Saw-Fish/ESP32-C6-MicroDev/Examples/Arduino/README.md

## Arduino Examples

* ESP32-C6-DEV-ID.ino this is the barebones Arduino code loaded onto the device when purchased.
