Saw-Fish/ESP32-C6-MicroDev/Micro-Dev-V0.1/V0.1 README.md

# ESP32-C6-MicroDev 

## V0.1 

Pins on bottom of board are broken out via unpopulated JST SH headers.

The step file includes these headers for reference.

## Pinouts:



## Known Issues:

The labels on the RESET & BOOT buttons are switched, this will be fixed in the next version. The BOOT button will reset the device and the RESET button will put it into download mode.

The board edge may be slightly larger than the step file, this is due to the mousebites from the manufacturing process, these can be safely smoothed over with a fine file.
