Saw-Fish/ESP32-C6-MicroDev/Micro-Dev-V0.1/C6-Dev-0.1 Pinout.png

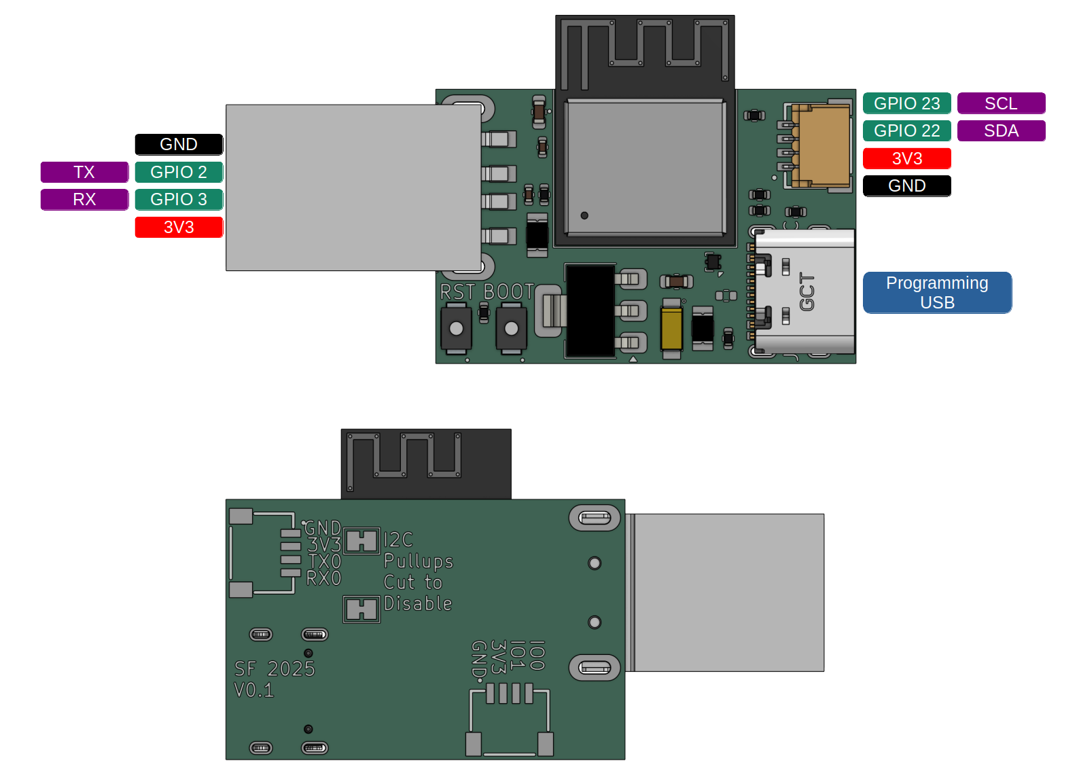
Micro-Dev-V0.1/C6-Dev-0.1 Pinout.png
