Saw-Fish/ESP32-C6-MicroDev/Micro-Dev-V0.1/ESP32-C6-MicroDev-V0.1 Schematic.pdf

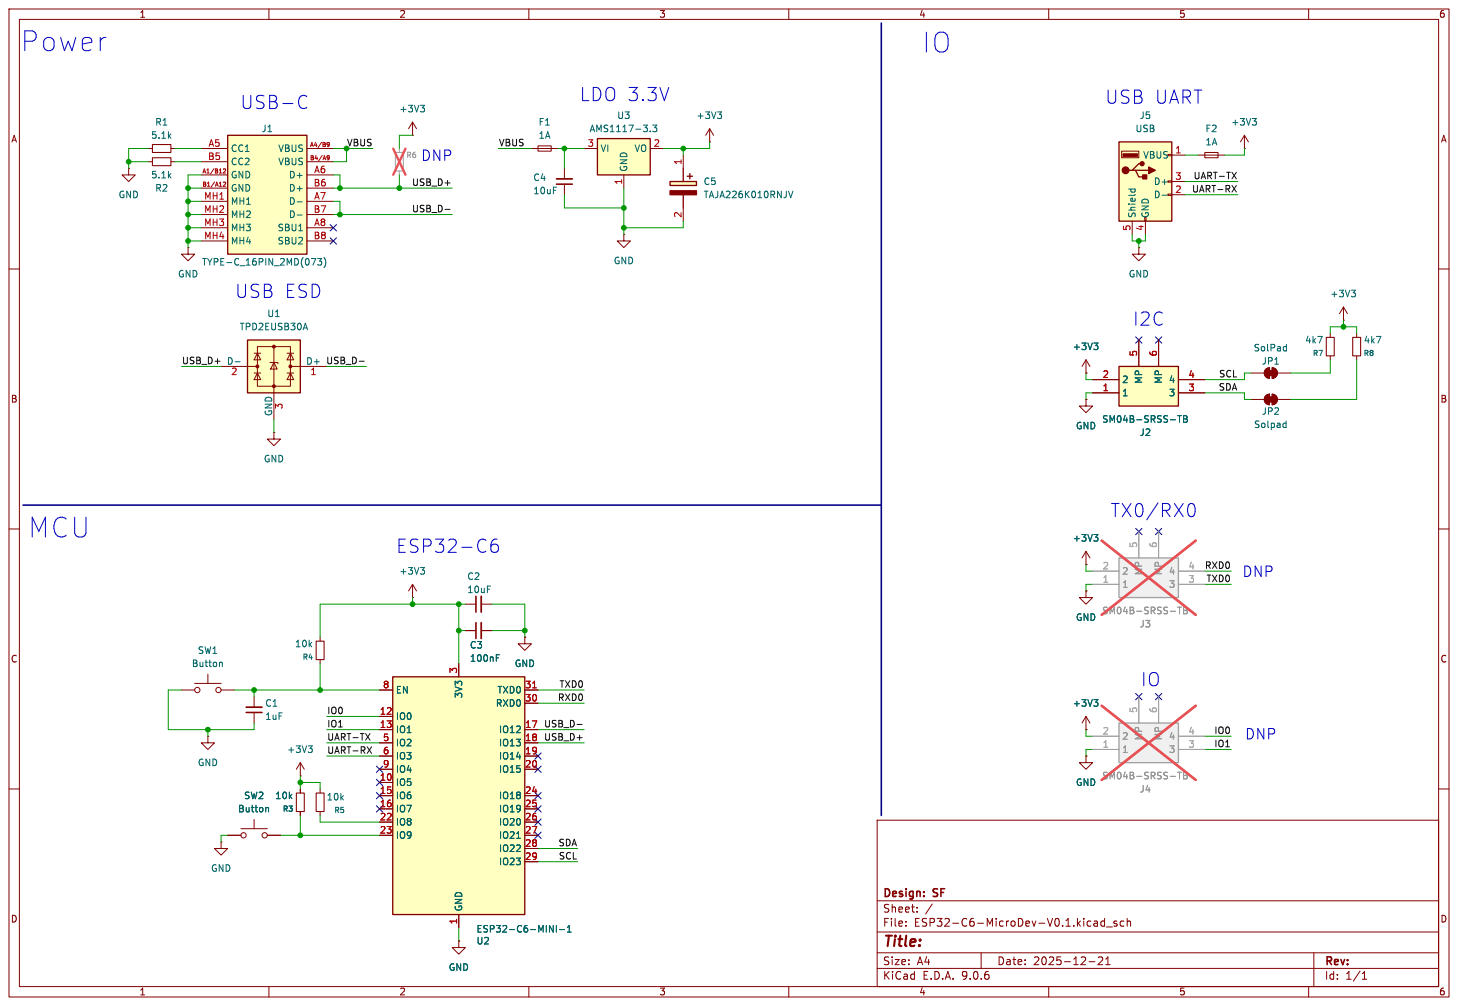
[picture p2: page 1]

UART-RX UART-TX

Id: 1/1 Title: File: ESP32-C6-MicroDev-V0.1.kicad_sch Sheet: / Design: SF
